simpish/orthball/images/btu.webp

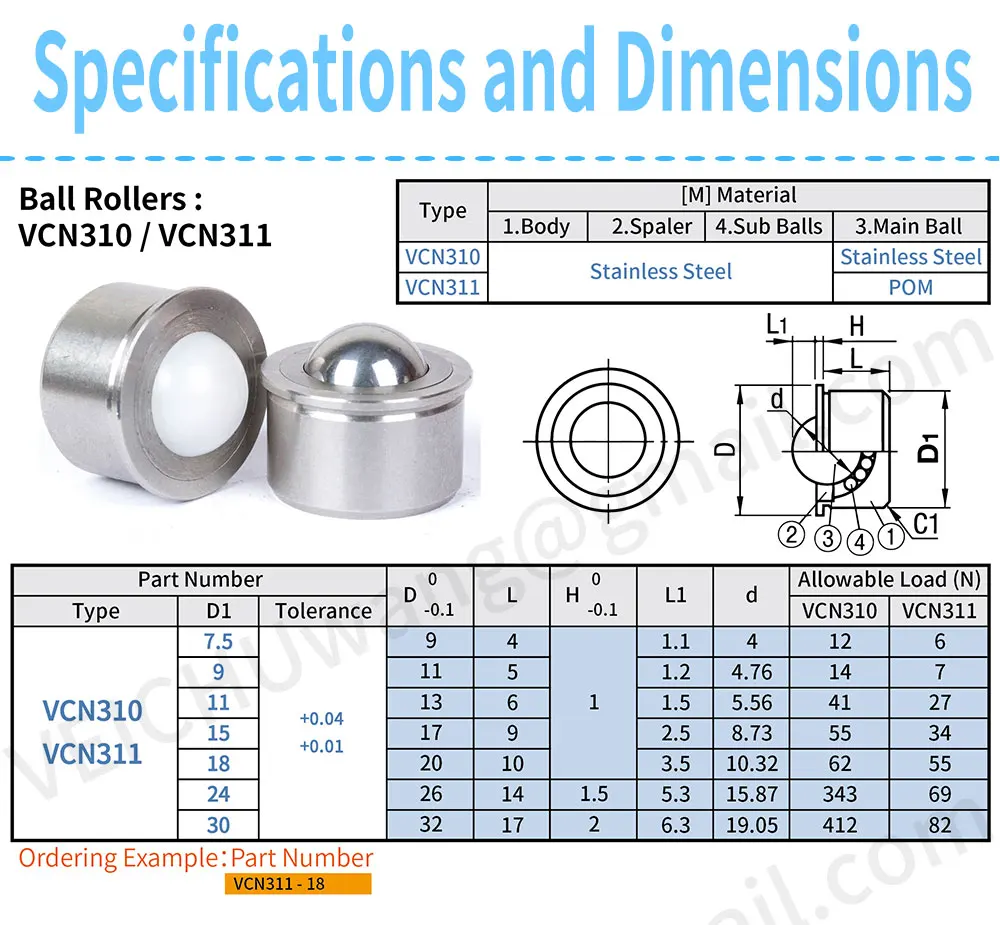
images/btu.webp
