simpish/orthball/docs/bom-v1.md

# OrthBall V1 — BOM（部品表）

> 最終更新: 2026-02-28

OrthBall V1 = On the 17クローン + 55mmトラックボール + OLEDディスプレイ + ロータリーエンコーダ

## 概要

- MCU: WaveShare RP2040-Zero (USB-C, 29GPIO)
- センサー: PMW3360 (SPI)
- ディスプレイ: 0.91inch OLED SSD1306 128×32 (I2C) ※手持ち
- エンコーダ: EC11 (プッシュスイッチ付き)
- キー数: 約65〜70キー (MX + ホットスワップ) ※レイアウト確定後に正確な数を反映
- ケース: 3Dプリント (PLA)

---

## 電子部品

| # | パーツ | 型番・仕様 | 数量 | 単価(税込) | 小計 | 購入先 | リンク |
|---|---|---|---|---|---|---|---|
| 1 | MCU | WaveShare RP2040-Zero | 1 | ¥770 | ¥770 | オレンジピコショップ(Yahoo) | [Yahoo](https://store.shopping.yahoo.co.jp/orangepicoshop/pico-m-050.html) |
| 2 | トラックボールセンサー | PMW3360 モジュール (センサー+レンズ+ブレイクアウト基板) | 1 | ¥2,378 | ¥2,378 | AliExpress | [AliExpress](https://ja.aliexpress.com/item/1005007729769668.html) |
| 3 | ダイオード | 1N4148W (SMD) | ~70個 | — | ¥0 | JLCPCB PCBA | PCB実装サービスで基板に実装済みで届く (Basic Parts) |
| 4 | ホットスワップソケット | Kailh MX用 (CPG151101S11) | 100個 | ¥1,449 | ¥1,449 | AliExpress | 50/100個セット (100個選択、V2用予備込み) |
| 5 | ロータリーエンコーダ | EC11互換 24クリック プッシュSW付 | 1 | ¥200 | ¥200 | 秋月電子 | [秋月](https://akizukidenshi.com/catalog/g/gP-14936/) |
| 6 | エンコーダ用ノブ | 6mm軸用 | 1 | ¥100 | ¥100 | 秋月電子 | — |

**小計: ¥4,320**

## ディスプレイ

| # | パーツ | 型番・仕様 | 数量 | 単価(税込) | 小計 | 購入先 | リンク |
|---|---|---|---|---|---|---|---|
| 7 | OLEDディスプレイ | 0.91inch SSD1306 128×32 I2C (基板38×12mm) | 1 | ¥0 | ¥0 | 手持ち (Corne等のキットに付属していたもの) | — |

**小計: ¥0**

> ※ 当初予定していた Waveshare 2.9inch Touch E-Paper HAT (¥4,510) は基板サイズ 89×43mm がキーボードに対して大きすぎたため変更
> ※ AliExpressで購入済みのE-Paper (¥2,669) は別用途で使用予定

## トラックボール

| # | パーツ | 型番・仕様 | 数量 | 単価(税込) | 小計 | 購入先 | リンク |
|---|---|---|---|---|---|---|---|
| 8 | 55mmボール | Perixx PERIPRO-304 (光沢仕上げ、赤 ※黒以外推奨) | 1 | ¥3,000 | ¥3,000 | Amazon JP | [Amazon](https://www.amazon.co.jp/dp/B07DXBMT6Z) |
| 9 | BTUベアリング | Veichu VCN310 7.5mm ステンレス | 3 | ¥479 | ¥1,437 | AliExpress | [AliExpress](https://www.aliexpress.com/item/1005003066404497.html) |

**小計: ¥4,800**

### トラックボール代替案（安価版）

BTUの代わりにセラミックベアリング球でも可。滑りは劣るが安い。

| パーツ | 仕様 | 数量 | 単価 | 小計 | 購入先 |
|---|---|---|---|---|---|
| セラミック球 | ZrO2 (ジルコニア) 3mm | 9個 | — | ¥300-500 | AliExpress |
| ベアリング受け | 3Dプリント | 3個 | — | ¥0 (自作) | — |

## キースイッチ・キーキャップ

| # | パーツ | 型番・仕様 | 数量 | 単価(税込) | 小計 | 購入先 | リンク |
|---|---|---|---|---|---|---|---|
| 10 | MXキースイッチ | お好みで (リニア/タクタイル/クリッキー) | 27+予備3 | ¥50-80 | ¥1,500-2,400 | 遊舎工房 / TALP | [遊舎工房](https://shop.yushakobo.jp/) / [TALP](https://shop.talpkeyboard.com/) |
| 11 | キーキャップ | Cherry MX互換 1Uセット | 27個 | — | ¥2,000-5,000 | 遊舎工房 / AliExpress | — |

**小計: ¥3,500〜7,400**

## ケース・配線・その他

| # | パーツ | 型番・仕様 | 数量 | 単価(税込) | 小計 | 購入先 |
|---|---|---|---|---|---|---|
| 12 | 3Dプリント フィラメント | PLA 1.75mm (使用量 ~100g) | — | — | ¥300 | 手持ち |
| 13 | USB-Cケーブル | データ通信対応 | 1 | ¥500 | ¥500 | Amazon / 手持ち |
| 14 | 配線材 | AWG28 シリコン被覆 | 1巻 | ¥300 | ¥300 | 秋月電子 |
| 15 | M2ネジ+スペーサーセット | M2×5mm, M2×8mm等 | 1セット | ¥500 | ¥500 | Amazon / 秋月 |
| 16 | ゴム足 | 滑り止め 8×2mm程度 | 4-6個 | ¥200 | ¥200 | Amazon / 秋月 |

**小計: ¥1,800**

## オプション（将来拡張用）

| # | パーツ | 型番・仕様 | 数量 | 単価(税込) | 小計 | 購入先 | 用途 |
|---|---|---|---|---|---|---|---|
| 17 | I/Oエキスパンダ | MCP23017 (I2C, +16GPIO) | 1 | ¥200 | ¥200 | 秋月電子 | GPIO不足時の拡張 |
| 18 | RGB LED | WS2812B (NeoPixel互換) | 10個 | ¥30 | ¥300 | AliExpress | キーバックライト |

---

## 合計見積もり

| カテゴリ | 金額 |
|---|---|
| 電子部品 (MCU/センサー/ソケット等) | ¥5,142 |
| ダイオード (JLCPCB実装) | ¥0 (PCB代に含む) |
| PCB (JLCPCB、ダイオード実装込み) | ¥1,500〜3,000 |
| ディスプレイ (OLED手持ち) | ¥0 |
| トラックボール (ボール+BTU) | ¥4,437 |
| キースイッチ+キーキャップ | ¥5,000〜10,000 |
| ケース・配線・その他 | ¥1,800 |
| **合計** | **¥17,879〜24,379** |

> ※ ダイオードはJLCPCB PCBA（SMT実装サービス）で基板実装済み
> ※ キー数が65〜70に増えたためスイッチ・キーキャップ費用も増加
> ※ 送料別。AliExpress注文は1,500円以上で送料無料（Choice）

---

## 購入先別まとめ

### AliExpress（注文済み）
- [x] PMW3360モジュール (¥2,378) — センサー+レンズ+ブレイクアウト基板
- [x] 2.9inch Touch E-Paper HAT (¥2,669) — ※キーボードには使用せず別用途

### 手持ち
- [x] OLED 0.91inch SSD1306 128×32 (Corne付属品)

### 秋月電子
- [ ] ロータリーエンコーダ EC11 (¥200)
- [ ] エンコーダ用ノブ (~¥100)
- [ ] 配線材 AWG28 (~¥300)

### 遊舎工房
- [ ] ダイオード 1N4148W SMD 100個 (¥300)
- [ ] Kailhホットスワップソケット 30個 (¥450)
- [ ] MXキースイッチ 30個 (¥1,500-2,400)
- [ ] キーキャップ (¥2,000-5,000)

### Amazon JP
- [ ] Perixx PERIPRO-304 55mmボール (¥3,000)
- [ ] M2ネジ+スペーサーセット (~¥500)
- [ ] ゴム足 (~¥200)
- [ ] USB-Cケーブル (~¥500)

### AliExpress / eBay
- [ ] RP2040-Zero (~¥600)
- [ ] BTU BOSCH Rexroth 8mm ×3 (~¥1,800)

### Yahoo (オレンジピコショップ) — AliExpressの代替
- [ ] RP2040-Zero (¥770)

---

## ピン割り当て (RP2040-Zero)

```
RP2040-Zero (表20ピン + 裏9パッド = 29GPIO)

【表面ピン (20本)】
├── キーマトリクス COL:  GP0, GP1, GP2, GP3, GP4, GP5  (6本)
├── キーマトリクス ROW:  GP6, GP7, GP8, GP9            (4本)
├── PMW3360 SPI0:       GP18(SCK), GP19(MOSI), GP16(MISO), GP17(CS)  (4本)
├── PMW3360 MOTION:     GP20                            (1本)
├── OLED I2C1:          GP14(SDA), GP15(SCL)            (2本)
├── ロータリーエンコーダ: GP26(A), GP27(B), GP28(SW)     (3本)
│
【裏面パッド (9本)】
└── 未使用:             GP10-13, GP21-25                (9本: LED/将来拡張)

使用: 20/29  余り: 9
```

> ※ ピン番号は仮。PCB設計時にI2Cバスの物理ピン制約に合わせて調整する
> ※ OLED変更により GPIO 9本余り → 将来のRGB LED、追加機能に余裕あり

---

## 技術メモ

### OLED (SSD1306 128×32)
- QMK標準OLEDドライバで対応（カスタムドライバ不要）
- I2C接続（SDA + SCL の2ピンのみ）
- 基板サイズ: 約38×12mm — 親指クラスター中央に配置
- DPI値、レイヤー名、スクロールモード等を表示

### PMW3360接続
- RP2040は3.3Vネイティブ → ブレイクアウト基板はレギュレータ搭載で5V/3.3V両対応
- SPI通信: SCLK, MOSI, MISO, CS + MOTION割り込みピン
- ブレイクアウト基板(28×32mm)はセンサーカップ底に配置、ワイヤーでメインPCBに接続

### GPIO拡張 (必要時)
- MCP23017 (I2C) で+16GPIO
- OLED I2Cバスに相乗り → 追加ピン不要
- OLED変更により9ピン余裕があるため、V1では不要の見込み
