simpish/orthball/cad/trackball_cup_v8.3mf

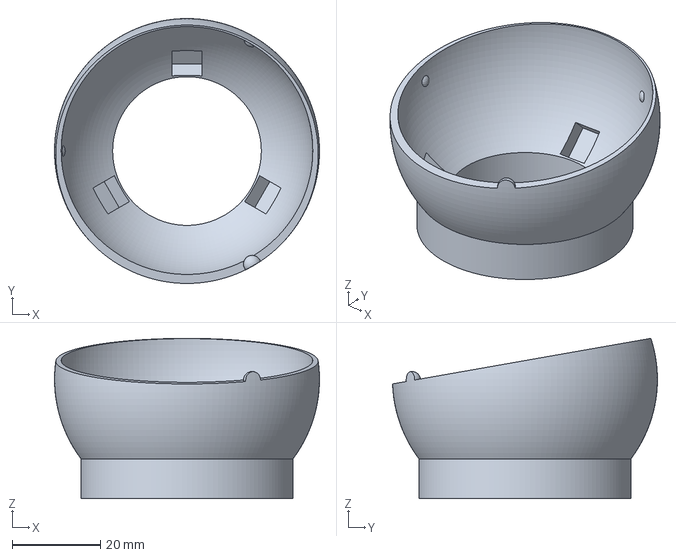
[picture p2: CAD file, 2026-03-30]
cad/trackball_cup_v8.3mf
60.0 x 60.0 x 36.3 mm
