simpish/orthball/cadquery/right_plate_v1.step

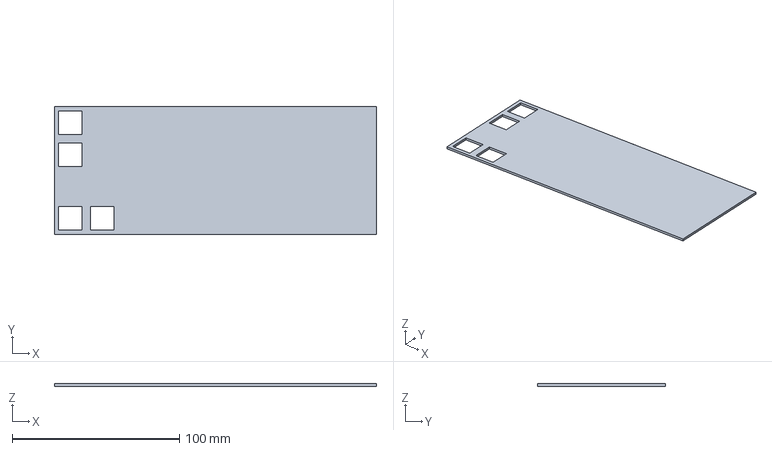
[picture p3: CAD file, 2026-03-15]
cadquery/right_plate_v1.step
192.3 x 76.2 x 1.50 mm
