simpish/orthball/cad/bearing_shim_0.5mm.stl

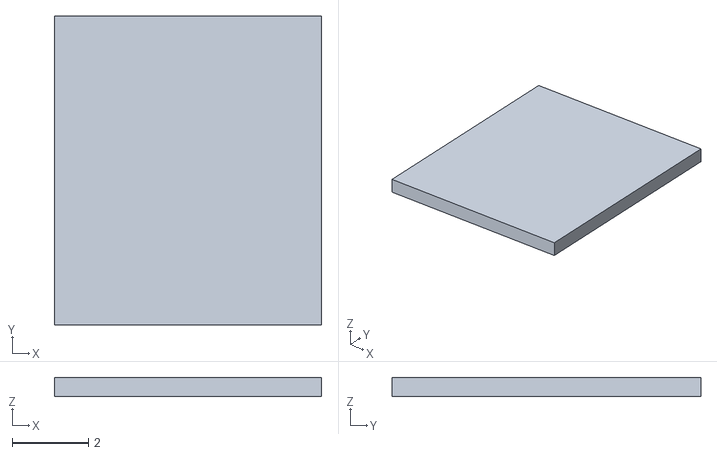
[picture p4: CAD file, 2026-03-30]
cad/bearing_shim_0.5mm.stl
7.00 x 8.10 x 0.5
