simpish/orthball/cadquery/right_case_v1.step

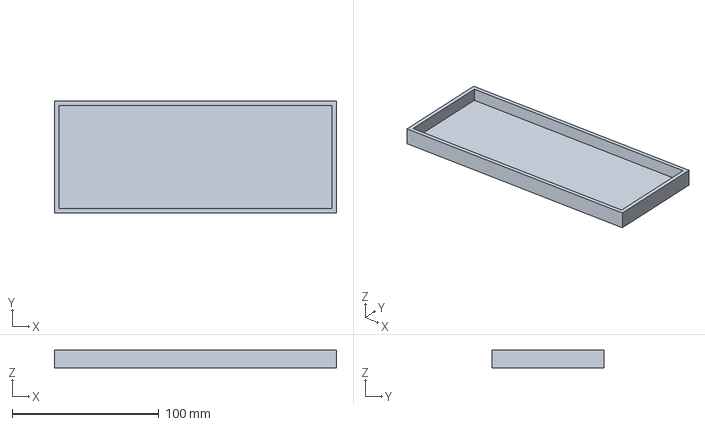
[picture p5: CAD file, 2026-03-15]
cadquery/right_case_v1.step
192.3 x 76.2 x 12.0 mm
