simpish/orthball/cad/orthball_plate_v7_left.3mf

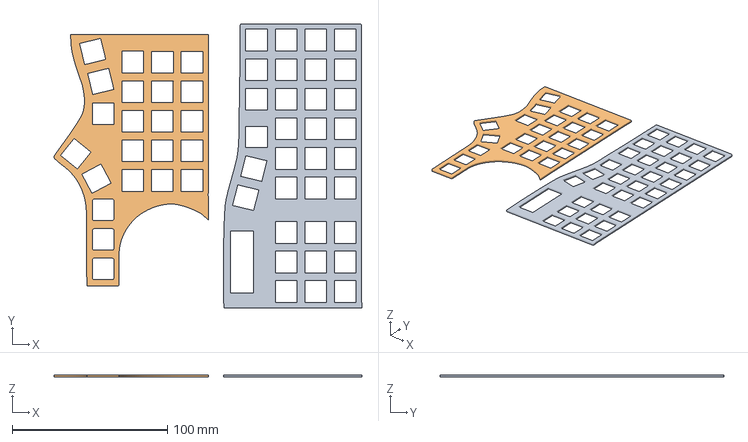
[picture p6: CAD file, 2026-03-15]
cad/orthball_plate_v7_left.3mf
198.3 x 183.2 x 1.50 mm
orthball_plate_v7_left.stl
orthball_plate_v7_right.stl
