simpish/orthball/cad/trackball_cup_55mm.stl

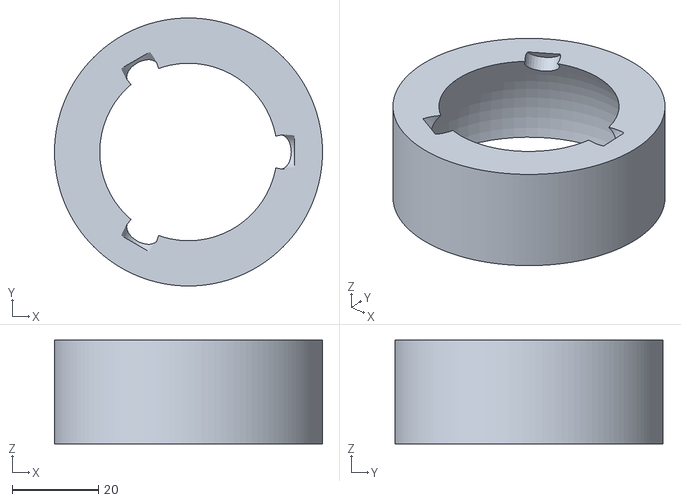
[picture p7: CAD file, 2026-03-15]
cad/trackball_cup_55mm.stl
62.0 x 62.0 x 24.0
