simpish/orthball/cad/trackball_55mm.stl

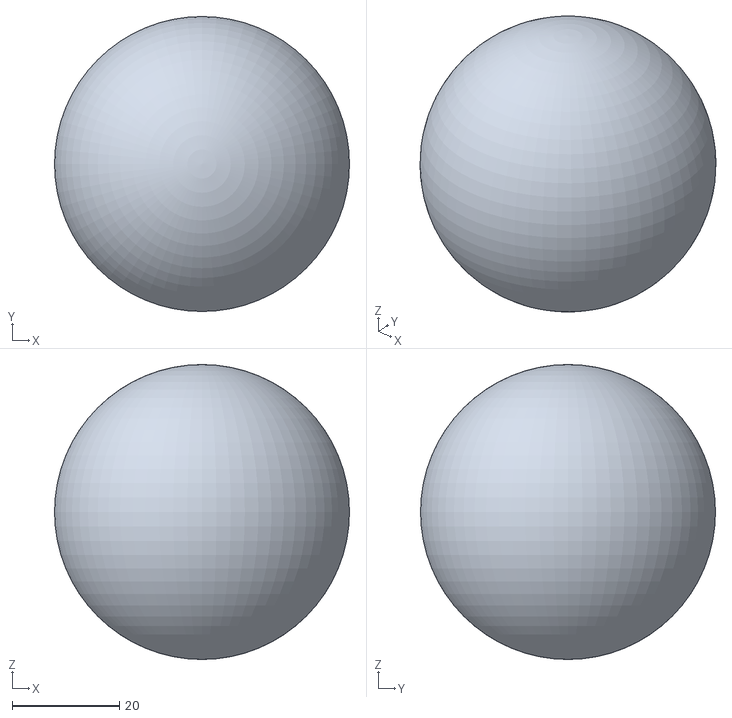
[picture p8: CAD file, 2026-03-15]
cad/trackball_55mm.stl
55.0 x 55.0 x 55.0
