simpish/orthball/cad/btu_test_block.stl

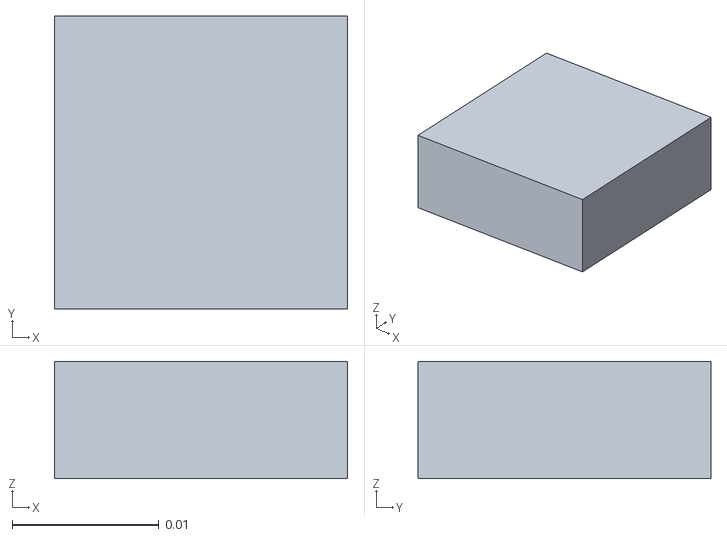
[picture p9: CAD file, 2026-03-15]
cad/btu_test_block.stl
0.02 x 0.02 x 0.008
