simpish/orthball/cad/orthball_plate_v7_right.stl

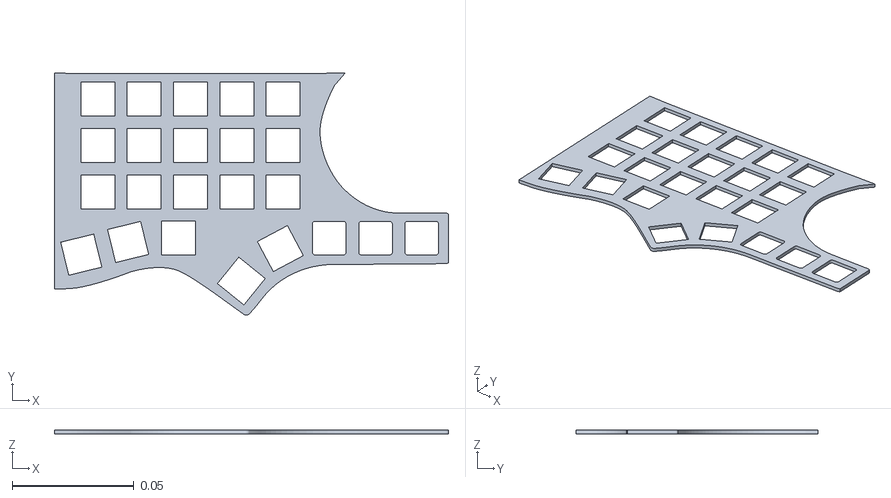
[picture p10: CAD file, 2026-03-15]
cad/orthball_plate_v7_right.stl
0.162 x 0.0996 x 0.0015
