simpish/orthball/cad/__old/orthball_walls_full.stl

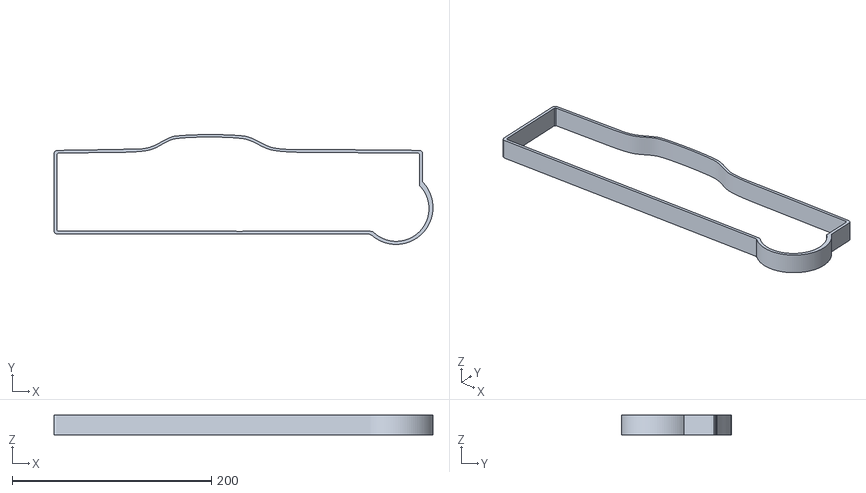
[picture p11: CAD file, 2026-03-15, an earlier design]
cad/__old/orthball_walls_full.stl
380.4 x 110.2 x 20.0
