simpish/orthball/cad/__old/orthball_plate_v4_svgextrude.stl

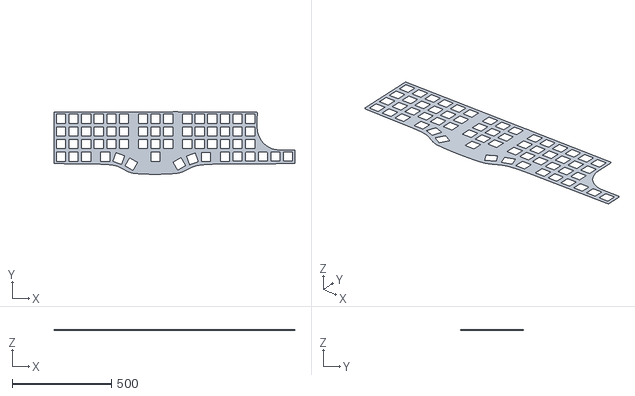
[picture p12: CAD file, 2026-03-15, an earlier design]
cad/__old/orthball_plate_v4_svgextrude.stl
1212.9 x 315.2 x 3.00
