simpish/orthball/cad/archive/trackball_cup_v3.stl

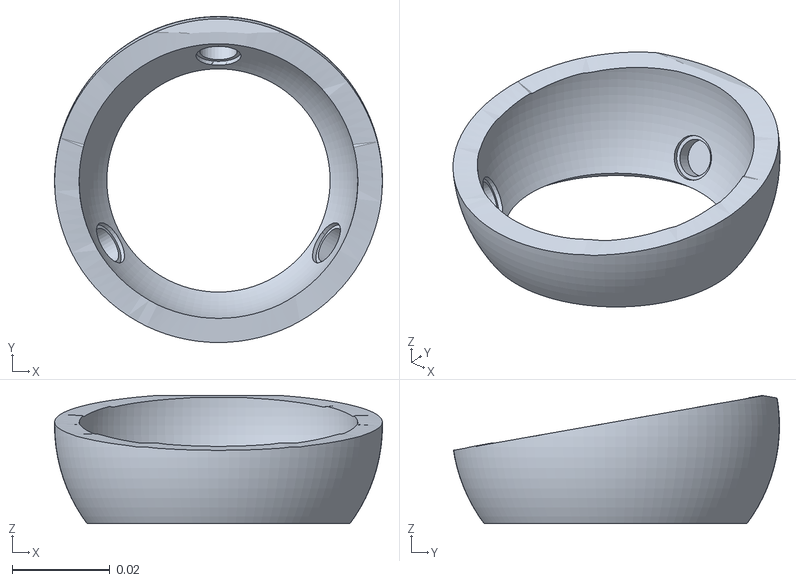
[picture p13: CAD file, 2026-03-30, an earlier design]
cad/archive/trackball_cup_v3.stl
0.067 x 0.0666 x 0.0262
