simpish/orthball/cad/__old/orthball_case_v5.3mf

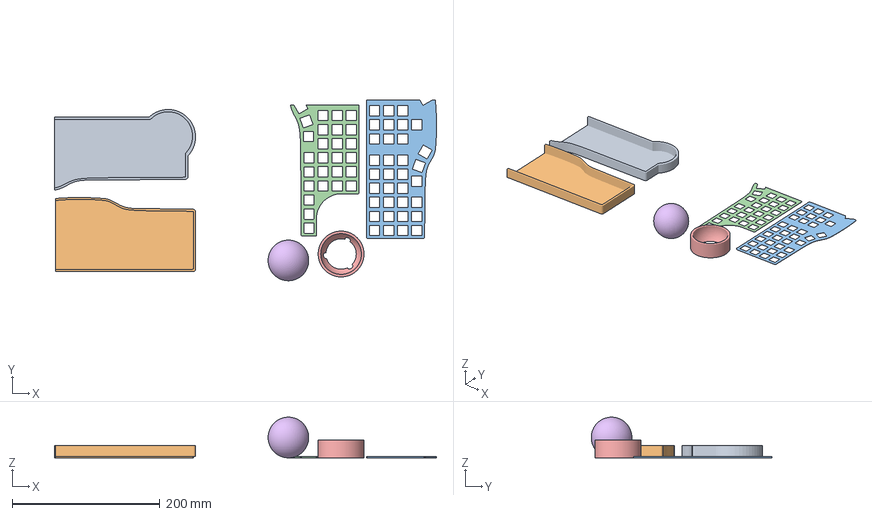
[picture p14: CAD file, 2026-03-15, an earlier design]
cad/__old/orthball_case_v5.3mf
516.4 x 244.0 x 55.0 mm
orthball_case_right.stl
orthball_case_left.stl
orthball_plate_left.stl
orthball_plate_right.stl
trackball_cup_55mm.stl
trackball_55mm.stl
