simpish/orthball/cad/archive/trackball_cup_v5_shallow.stl

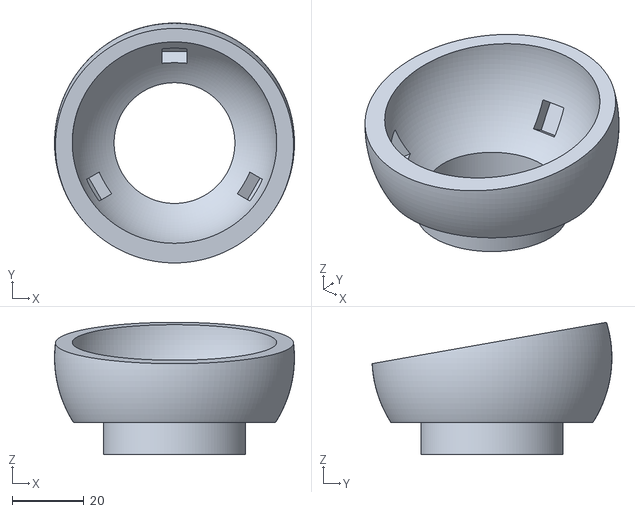
[picture p15: CAD file, 2026-03-30, an earlier design]
cad/archive/trackball_cup_v5_shallow.stl
66.9 x 66.8 x 36.9
