simpish/orthball/cad/archive/trackball_cup_v6.stl

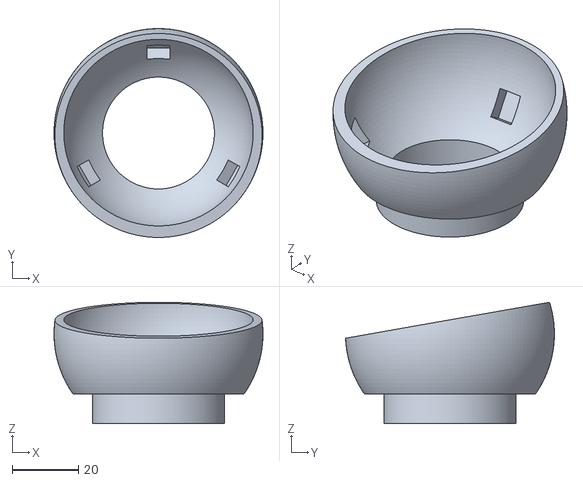
[picture p16: CAD file, 2026-03-30, an earlier design]
cad/archive/trackball_cup_v6.stl
62.9 x 62.8 x 36.5
