simpish/orthball/cad/archive/trackball_cup_v7_lat40.stl

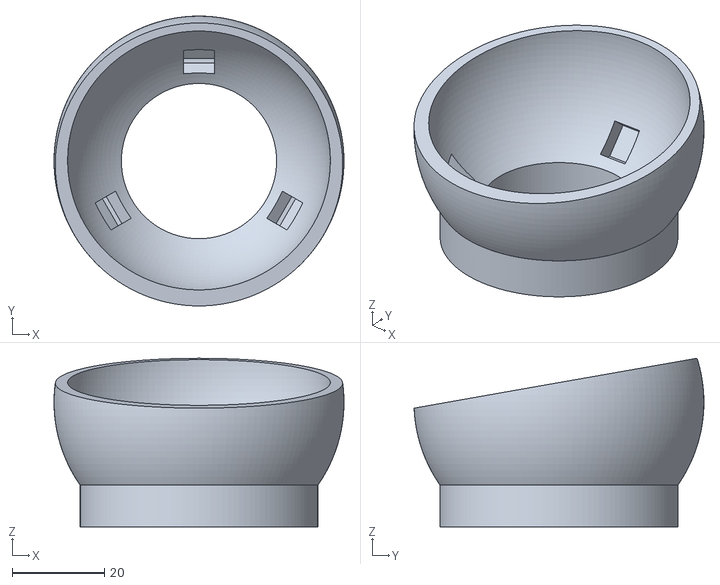
[picture p17: CAD file, 2026-03-30, an earlier design]
cad/archive/trackball_cup_v7_lat40.stl
62.9 x 62.8 x 36.5
