simpish/orthball/cad/__old/orthball_plate_right.stl

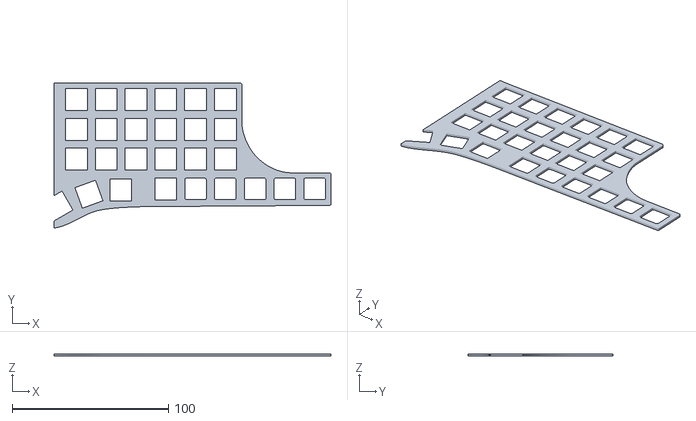
[picture p18: CAD file, 2026-03-15, an earlier design]
cad/__old/orthball_plate_right.stl
177.2 x 92.9 x 1.50
