simpish/orthball/(list of files, cad)

Other CAD files:
cad/__old/orthball_plate_v6.dxf
cad/__old/mockup_v1.step
cad/__old/mockup_v2.step
cad/__old/mockup_v2.stl
cad/__old/orthball_case_left.stl
cad/__old/orthball_case_right.stl
cad/__old/orthball_case_v4.stl
cad/__old/orthball_case_v5.stl
cad/__old/orthball_case_v5_real.stl
cad/__old/orthball_plate_left.stl
cad/__old/orthball_plate_v5_real.stl
cad/__old/orthball_walls_left.3mf
cad/__old/orthball_walls_left.stl
cad/__old/orthball_walls_right.stl
cad/archive/trackball_cup_base.blend
cad/archive/trackball_cup_pre_boolean.blend
cad/archive/trackball_cup_v2.stl
cad/archive/trackball_cup_v4_bearing.blend
cad/archive/trackball_cup_v5_shallow.blend
cad/archive/trackball_cup_v6.blend
cad/archive/trackball_cup_v7.blend
cad/archive/trackball_cup_v7.stl
cad/archive/trackball_cup_v7_lat35.stl
cad/archive/trackball_cup_v7_lat45_rib.stl
cad/archive/trackball_cup_with_btu.blend
cad/orthball_plate_v7_left.stl
cad/trackball_cup_base.blend
cad/trackball_cup_pre_boolean.blend
cad/trackball_cup_v2.stl
cad/trackball_cup_v8.blend
cad/trackball_cup_v8.stl
cad/trackball_cup_with_btu.blend
cadquery/right_case_v1.stl
cadquery/right_plate_v1.stl
