simpish/orthball/cad/__old/orthball_plate_v2.pdf

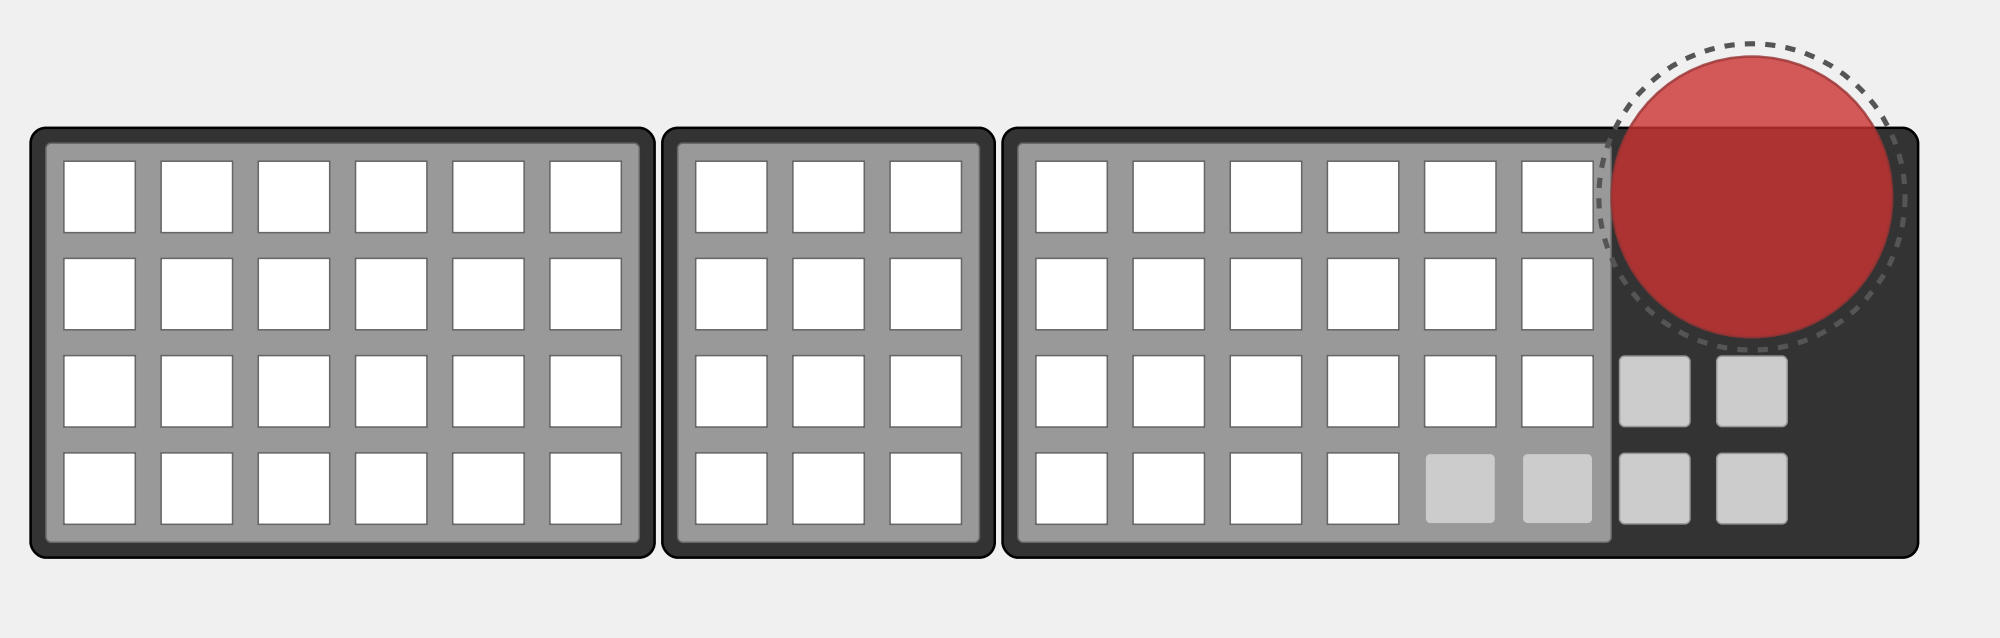
[picture p19: page 1]
