simpish/orthball/kicad/orthball.kicad_sch

## KiCad design kicad/orthball.kicad_sch (2026-03-15)

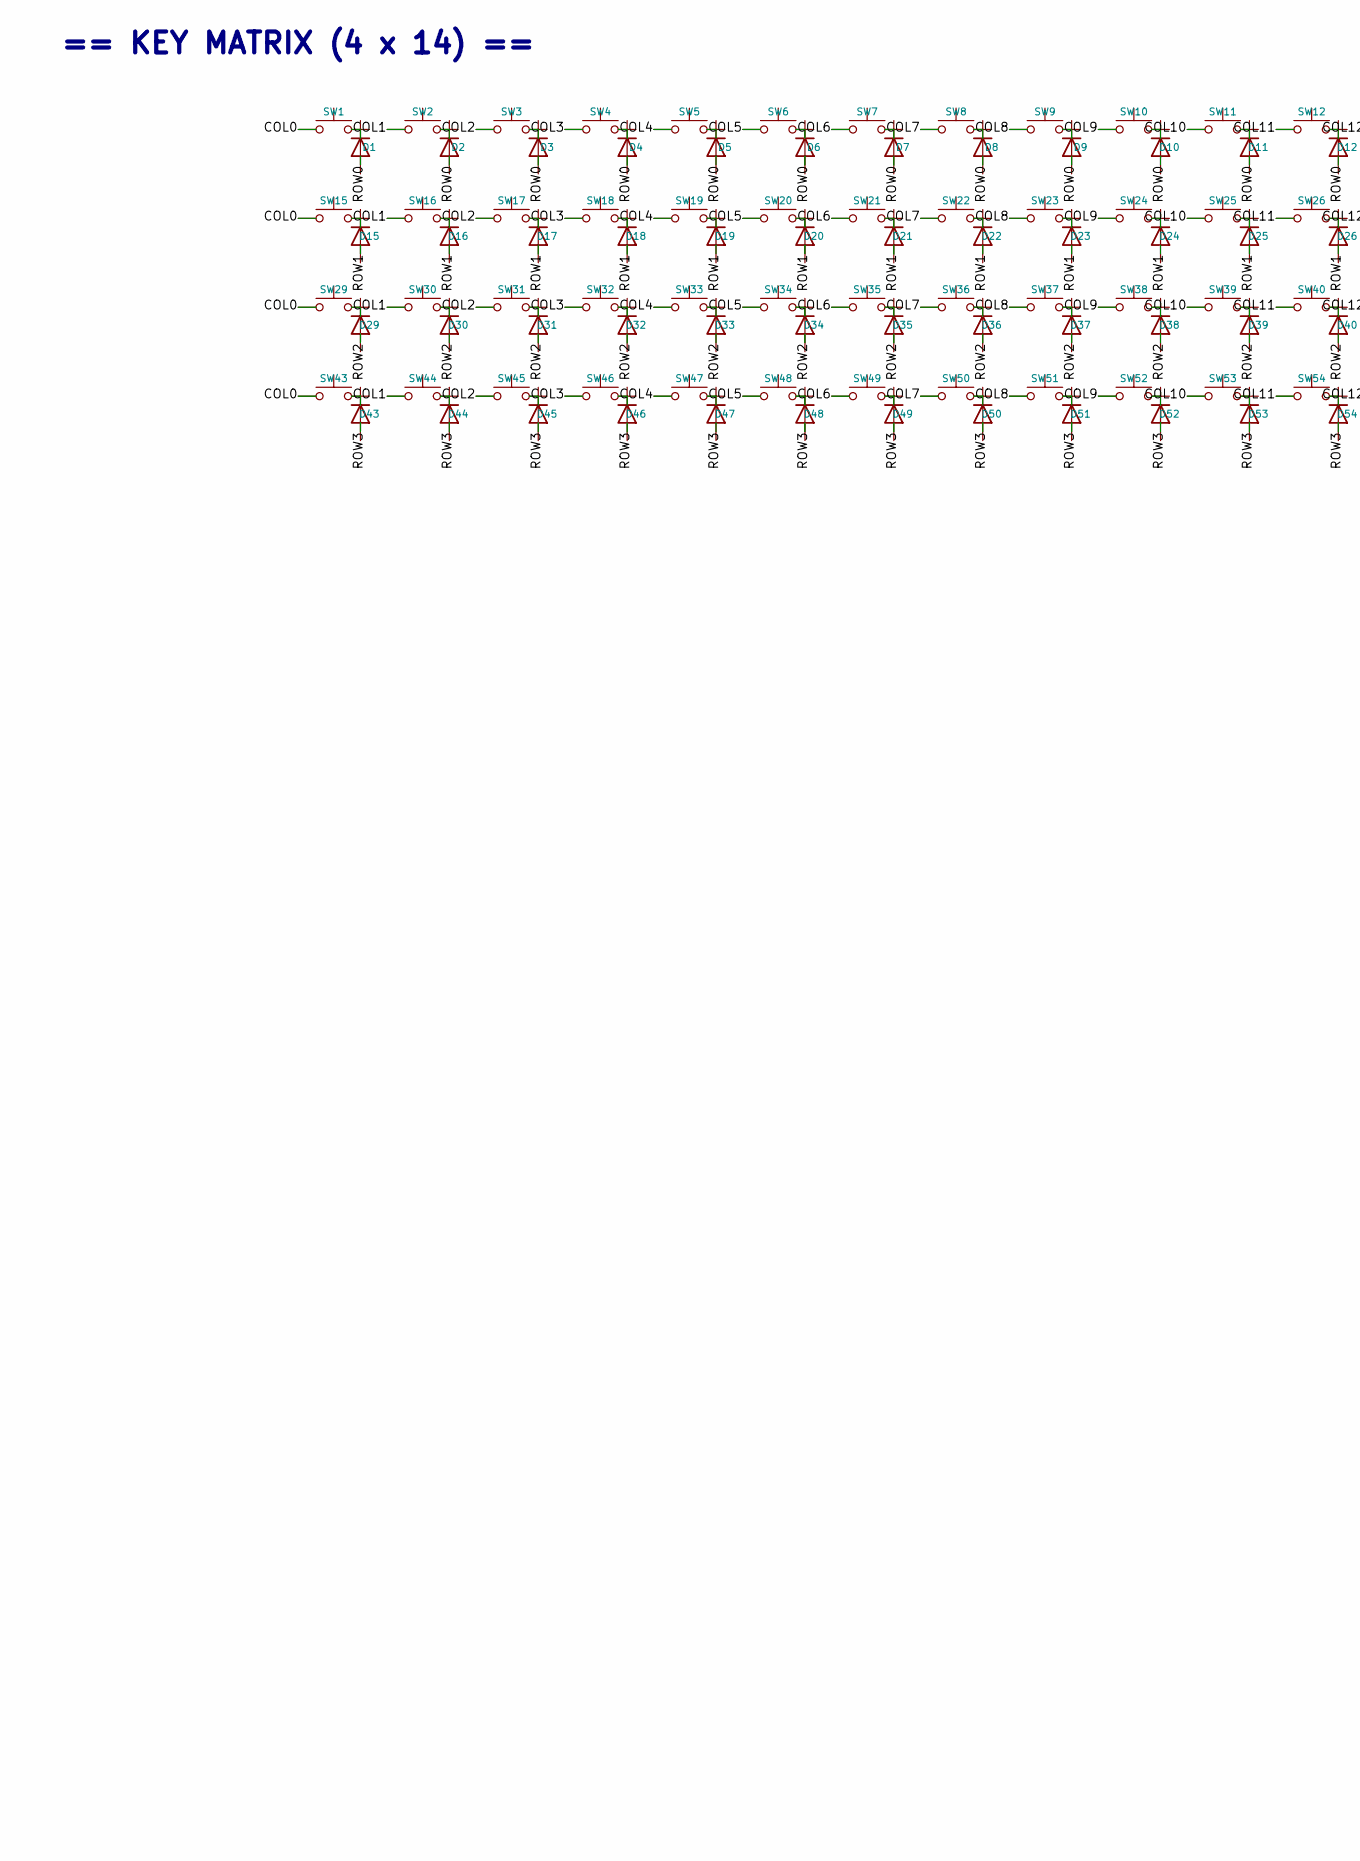
[picture p20: schematic orthball.kicad_sch, part in row 1, column 1]

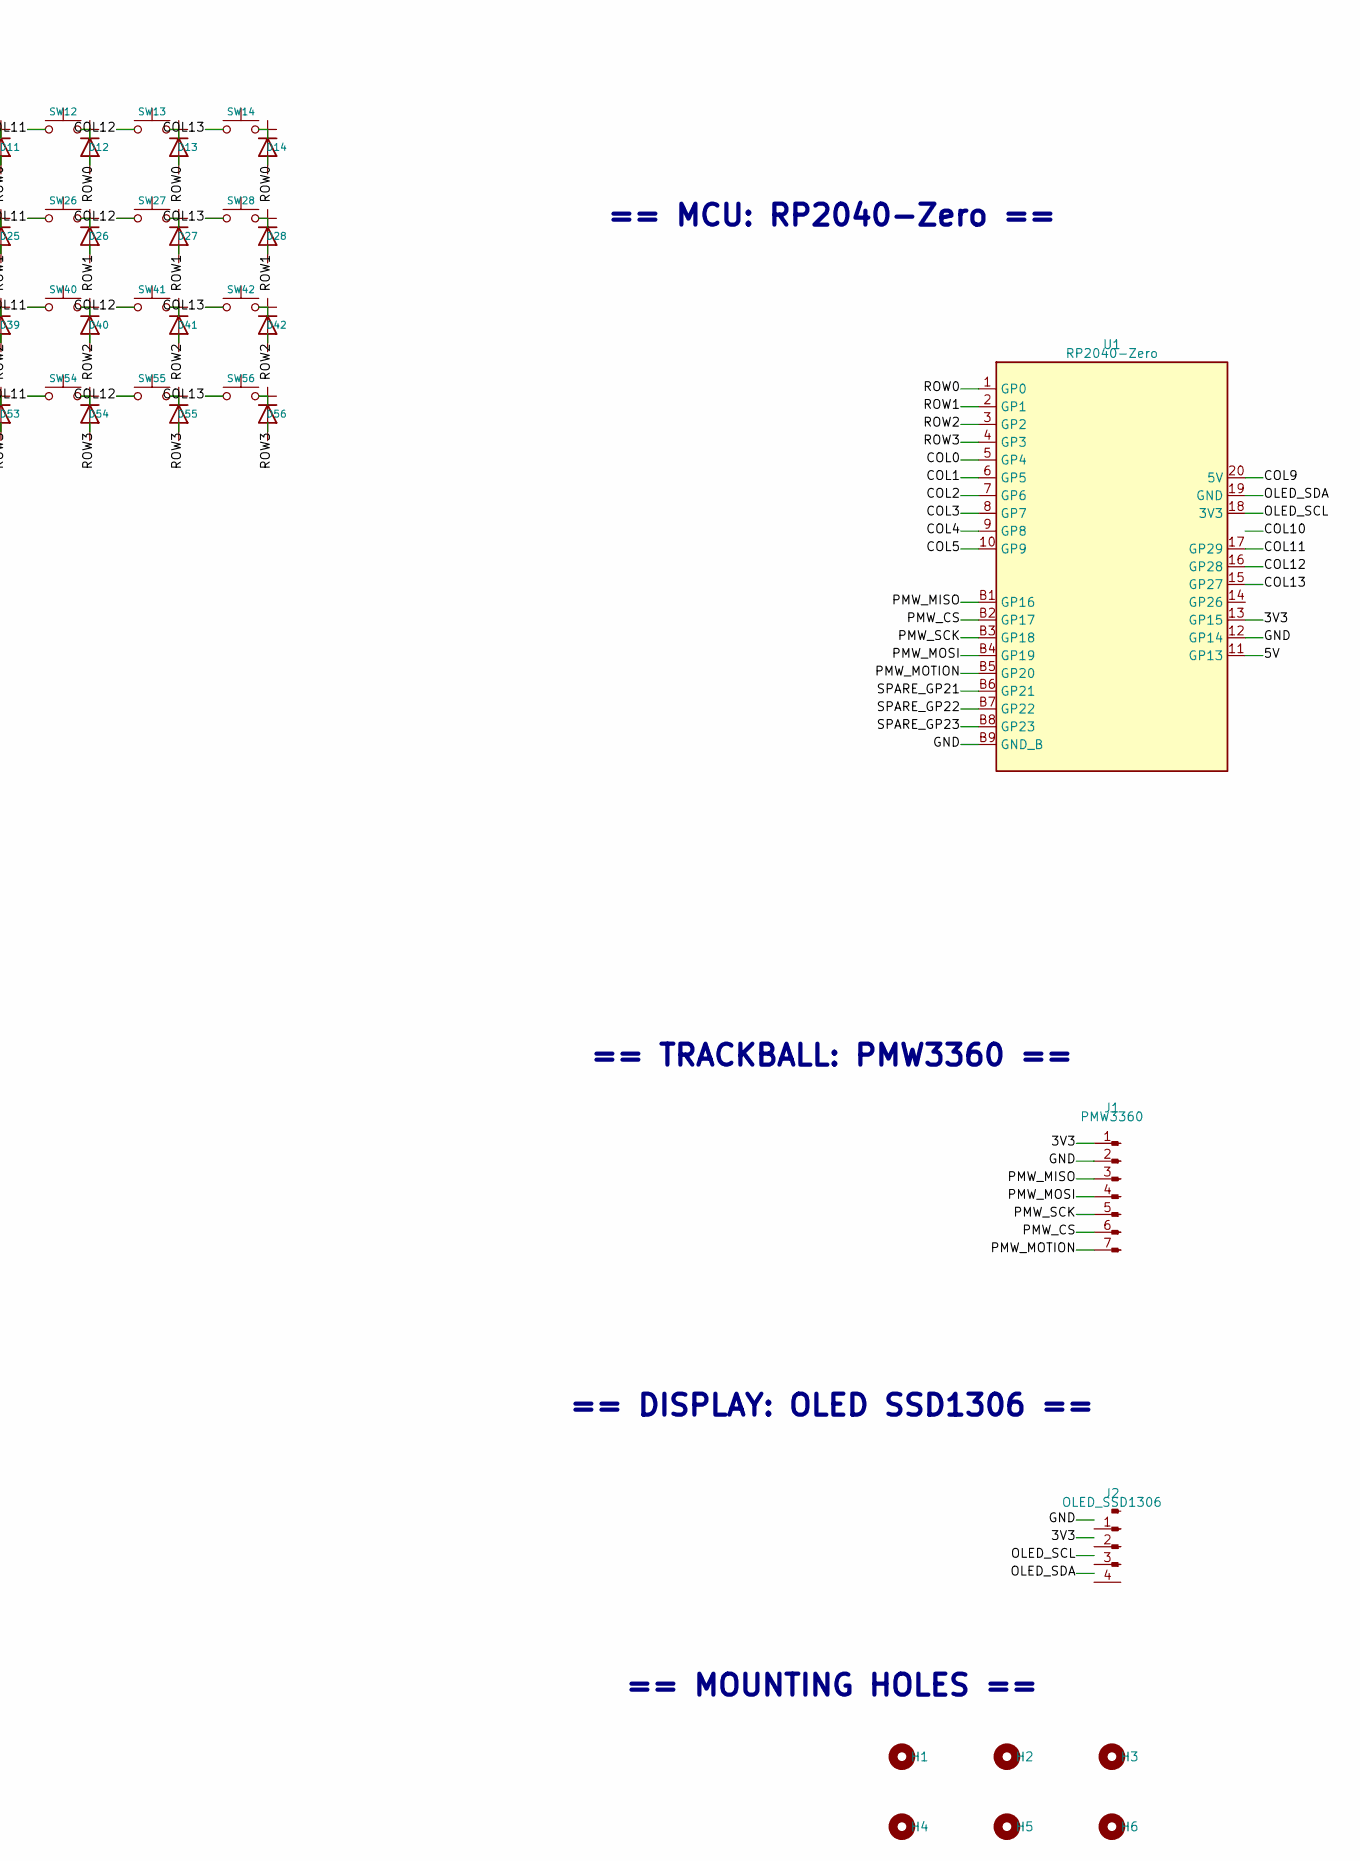
[picture p21: schematic orthball.kicad_sch, part in row 1, column 2]

Parts:
D1, D2, D3, D4, D5, D6, D7, D8, D9, D10, D11, D12, D13, D14, D15, D16, D17, D18, D19, D20, D21, D22, D23, D24, D25, D26, D27, D28, D29, D30, D31, D32, D33, D34, D35, D36, D37, D38, D39, D40, D41, D42, D43, D44, D45, D46, D47, D48, D49, D50, D51, D52, D53, D54, D55, D56: 1N4148W; D_SOD-123
H1, H2, H3, H4, H5, H6: M2; MountingHole_2.2mm_M2
J1: PMW3360; PinHeader_1x07_P2.54mm_Vertical
J2: OLED_SSD1306; PinHeader_1x04_P2.54mm_Vertical
SW1, SW2, SW3, SW4, SW5, SW6, SW7, SW8, SW9, SW10, SW11, SW12, SW13, SW14, SW15, SW16, SW17, SW18, SW19, SW20, SW21, SW22, SW23, SW24, SW25, SW26, SW27, SW28, SW29, SW30, SW31, SW32, SW33, SW34, SW35, SW36, SW37, SW38, SW39, SW40, SW41, SW42, SW43, SW44, SW45, SW46, SW47, SW48, SW49, SW50, SW51: SW_Push; SW_MX_HS_CPG151101S11_1u
SW52, SW53, SW54, SW55, SW56: SW_Push; SW_choc_v1_HS_CPG135001S30_1u
U1: RP2040-Zero

Connections:
3V3: J1.1, U1.13 (GP15)
5V: U1.11 (GP13)
COL0: SW1.1, SW15.1, SW29.1, SW43.1, U1.5 (GP4)
COL1: SW2.1, SW16.1, SW30.1, SW44.1, U1.6 (GP5)
COL2: SW3.1, SW17.1, SW31.1, SW45.1, U1.7 (GP6)
COL3: SW4.1, SW18.1, SW32.1, SW46.1, U1.8 (GP7)
COL4: SW5.1, SW19.1, SW33.1, SW47.1, U1.9 (GP8)
COL5: SW6.1, SW20.1, SW34.1, SW48.1, U1.10 (GP9)
COL6: SW7.1, SW21.1, SW35.1, SW49.1
COL7: SW8.1, SW22.1, SW36.1, SW50.1
COL8: SW9.1, SW23.1, SW37.1, SW51.1
COL9: SW10.1, SW24.1, SW38.1, SW52.1, U1.20 (5V)
COL10: SW11.1, SW25.1, SW39.1, SW53.1
COL11: SW12.1, SW26.1, SW40.1, SW54.1, U1.17 (GP29)
COL12: SW13.1, SW27.1, SW41.1, SW55.1, U1.16 (GP28)
COL13: SW14.1, SW28.1, SW42.1, SW56.1, U1.15 (GP27)
GND: J1.2, U1.12 (GP14), U1.B9 (GND_B)
OLED_SCL: U1.18 (3V3)
OLED_SDA: U1.19 (GND)
PMW_CS: J1.6, U1.B2 (GP17)
PMW_MISO: J1.3, U1.B1 (GP16)
PMW_MOSI: J1.4, U1.B4 (GP19)
PMW_MOTION: J1.7, U1.B5 (GP20)
PMW_SCK: J1.5, U1.B3 (GP18)
ROW0: U1.1 (GP0)
ROW1: U1.2 (GP1)
ROW2: U1.3 (GP2)
ROW3: U1.4 (GP3)
SPARE_GP21: U1.B6 (GP21)
SPARE_GP22: U1.B7 (GP22)
SPARE_GP23: U1.B8 (GP23)

Notes on the sheet:
== KEY MATRIX (4 x 14) ==
== MCU: RP2040-Zero ==
== TRACKBALL: PMW3360 ==
== DISPLAY: OLED SSD1306 ==
== MOUNTING HOLES ==
