simpish/orthball/(commit log)

2026-02-27 Add BOM v1 and project files
2026-02-28 BOM v1.1: E-Ink→OLED変更、PMW3360をAliExpress版に更新
2026-02-28 BOM v1.2: キー数修正(~70), BTU→Veichu, ダイオードJLCPCB実装, ソケットAliExpress
2026-03-15 Add all local project files: CAD, docs, configs, and design history
    Includes plate SVGs (v3-v7), trackball cup (Blender + STL),
    Cosmos/Ergogen configs, CadQuery models, design docs, and KLE layouts.
    [btu_test_block.stl, mockup_v1.step, mockup_v2.step, mockup_v2.stl, orthball_case_left.stl, orthball_case_right.stl, orthball_case_v4.stl, orthball_case_v5.3mf]
2026-03-15 Add KiCad PCB design: schematic, footprints, Edge.Cuts, and placement scripts
    - Custom RP2040-Zero symbol (28 GPIO + power) and footprint (20 THT + 9 castellated SMD)
    - Full schematic: 56 switches (51 MX + 5 Choc) with 1N4148W diodes in 4x14 matrix,
    PMW3360 7-pin header, OLED 4-pin header, 6x M2 mounting holes
    - SVG outline → Edge.Cuts conversion with key holes from JSON coordinates
    - Auto-placement script for switches, diodes, MCU, headers, and mounting holes
    - Library tables for orthball, marbastlib-mx, marbastlib-choc
    [orthball.kicad_pcb, orthball.kicad_sch]
2026-03-16 Fix RP2040-Zero footprint with measured dimensions
    - Height: 23.5mm → 24.0mm (measured with calipers)
    - Bottom pads: 9 → 10 (confirmed via WaveShare wiki)
    - Add GP24/GP25 to symbol (total 29 GPIO + power)
    - Bottom pad pitch: 1.27mm for 10 pads
    [generate_footprint.py]
2026-03-30 Trackball cup v8: M-BS10ベアリング対応、lat=-45°、リブ付き
    - M-BS10実測値でポケット設計 (6.8x7.9mm, +0.1mmクリアランス)
    - 可変壁厚 (縁1.1mm→底部4.8mm) by外側球オフセット方式
    - ベアリング南緯45°配置 (減速係数2.0、慣性回転最適)
    - 半球リブ3箇所 (R=2mm、突出0.5mm、横ズレ防止)
    - 台座9mm (球クリアランス3.5mm)
    - 0.5mmシムプレート (深さ調整用)
    - 旧版v1-v7をcad/archive/に整理
    [bearing_shim_0.5mm.stl, trackball_cup_55mm.stl, trackball_cup_base.blend, trackball_cup_pre_boolean.blend, trackball_cup_v2.stl, trackball_cup_v3.stl, trackball_cup_v4_bearing.blend, trackball_cup_v4_bearing.stl]
